theantennaguy/vco-max2870-evalboard/max2871-evalboard/datasheets/Stackup.png

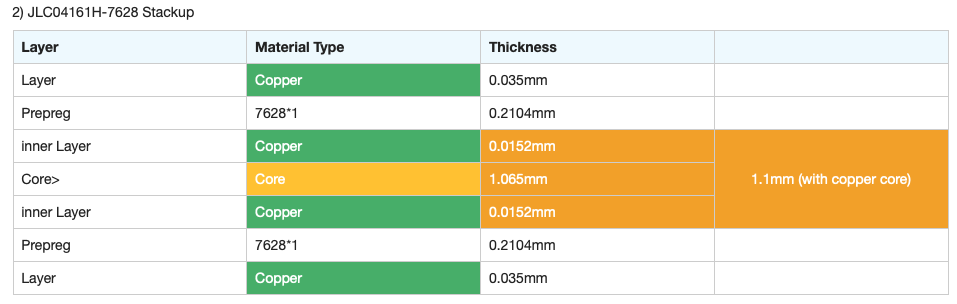
max2871-evalboard/datasheets/Stackup.png
