theantennaguy/vco-max2870-evalboard/max2871-evalboard/parts/CONSMA002-L_SMA_COAX_CONN/CONSMA002-L.step

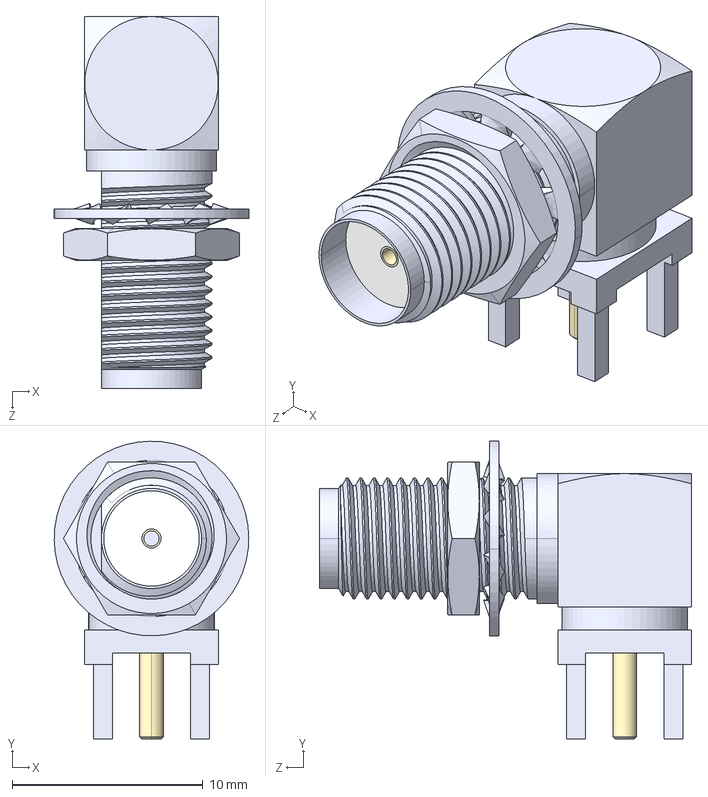
[picture p2: CAD file, 2022-12-02]
max2871-evalboard/parts/CONSMA002-L_SMA_COAX_CONN/CONSMA002-L.step
10.2 x 15.6 x 19.5 mm
CONSMA002-L-body
Nut
Washer
