theantennaguy/vco-max2870-evalboard/max2871-evalboard/parts/IRF7301.STEP

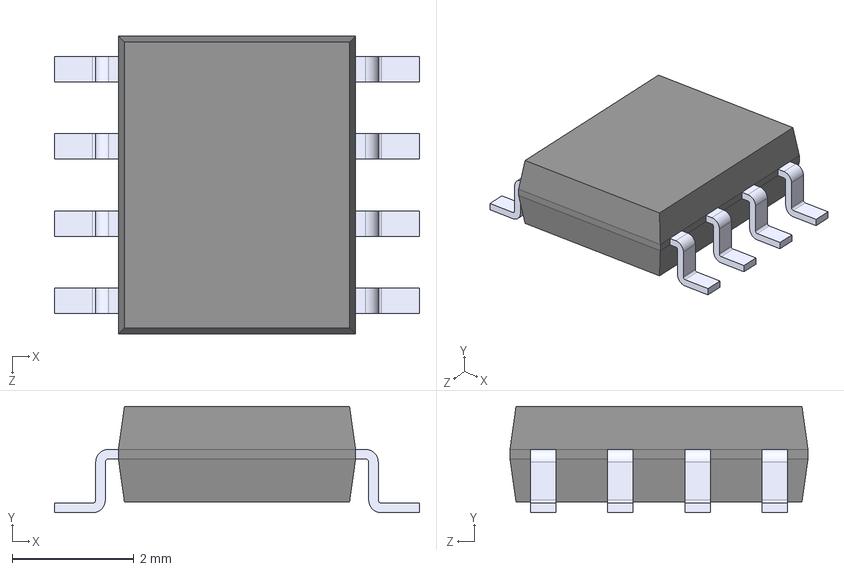
[picture p3: CAD file, 2022-12-21]
max2871-evalboard/parts/IRF7301.STEP
6.00 x 1.75 x 4.90 mm
