theantennaguy/vco-max2870-evalboard/max2871-evalboard/parts/LMH2110TM_NOPB/LMH2110TM_NOPB.step

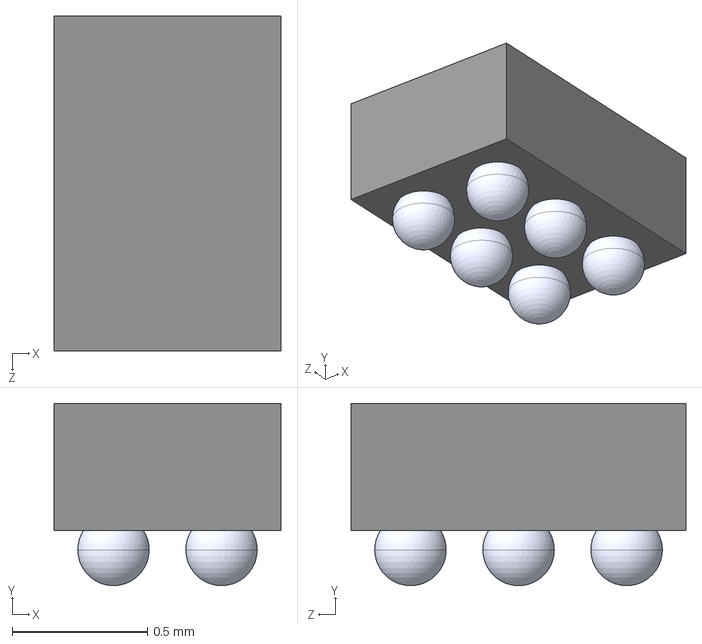
[picture p4: CAD file, 2023-01-11]
max2871-evalboard/parts/LMH2110TM_NOPB/LMH2110TM_NOPB.step
0.84 x 0.675 x 1.24 mm
