theantennaguy/vco-max2870-evalboard/max2871-evalboard/parts/MAX2871ETJ/MAX2871ETJ_.step

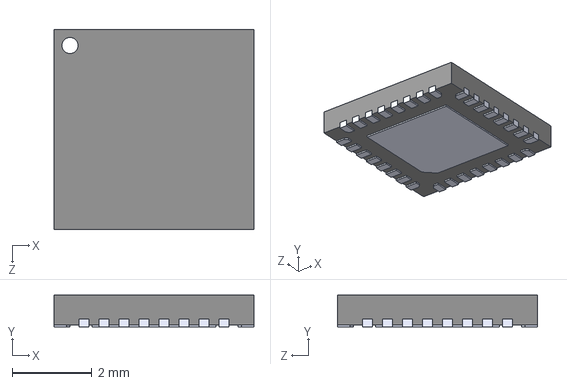
[picture p5: CAD file, 2022-12-02]
max2871-evalboard/parts/MAX2871ETJ/MAX2871ETJ_.step
5.00 x 0.8 x 5.00 mm
