theantennaguy/vco-max2870-evalboard/max2871-evalboard/parts/MAX8559ETAAAT/MAX8559ETAAAT.step

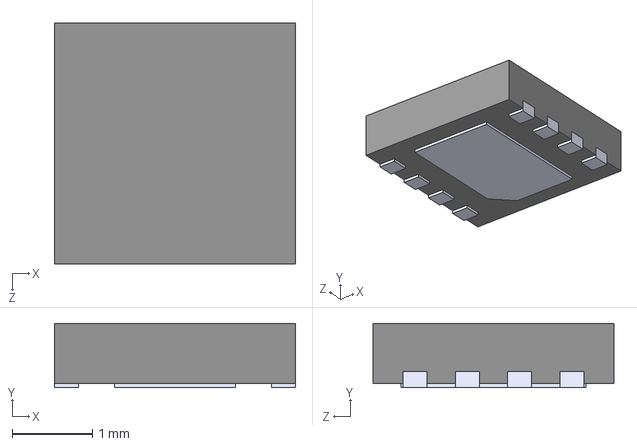
[picture p6: CAD file, 2022-12-02]
max2871-evalboard/parts/MAX8559ETAAAT/MAX8559ETAAAT.step
3.00 x 0.8 x 3.00 mm
