theantennaguy/vco-max2870-evalboard/max2871-evalboard/parts/TL3365AF180QG/TL3365AF180QG.step

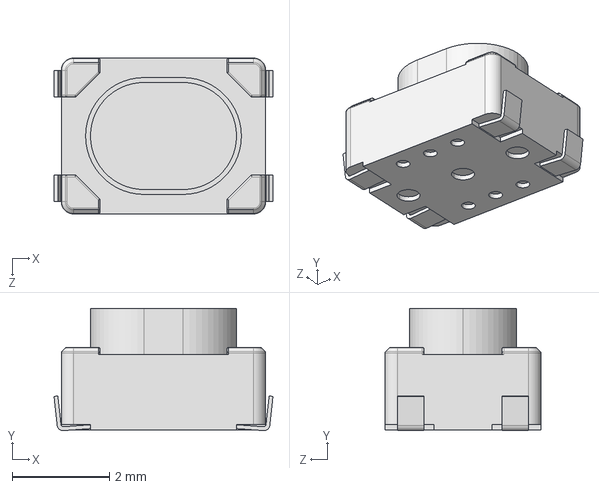
[picture p7: CAD file, 2022-12-02]
max2871-evalboard/parts/TL3365AF180QG/TL3365AF180QG.step
4.50 x 2.51 x 3.20 mm
