theantennaguy/vco-max2870-evalboard/max2871-evalboard/parts/USB-B1HSB6/USB-B1HSB6.step

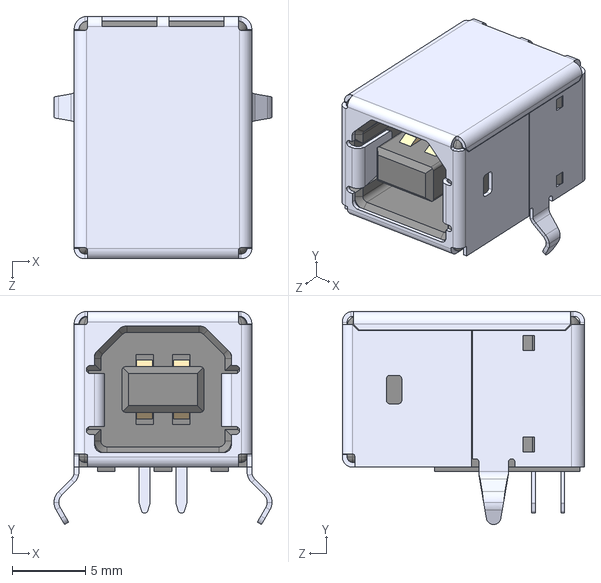
[picture p8: CAD file, 2022-12-02]
max2871-evalboard/parts/USB-B1HSB6/USB-B1HSB6.step
14.8 x 14.5 x 16.5 mm
