theantennaguy/vco-max2870-evalboard/max2871-evalboard/parts/USB4105-GF-A/USB4105-GF-A.step

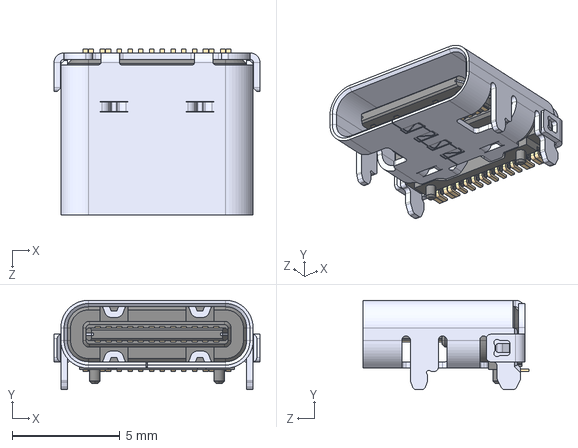
[picture p9: CAD file, 2023-01-11]
max2871-evalboard/parts/USB4105-GF-A/USB4105-GF-A.step
9.58 x 4.16 x 7.71 mm
