theantennaguy/vco-max2870-evalboard/max2871-evalboard/parts/54819-0519/54819-0519.step

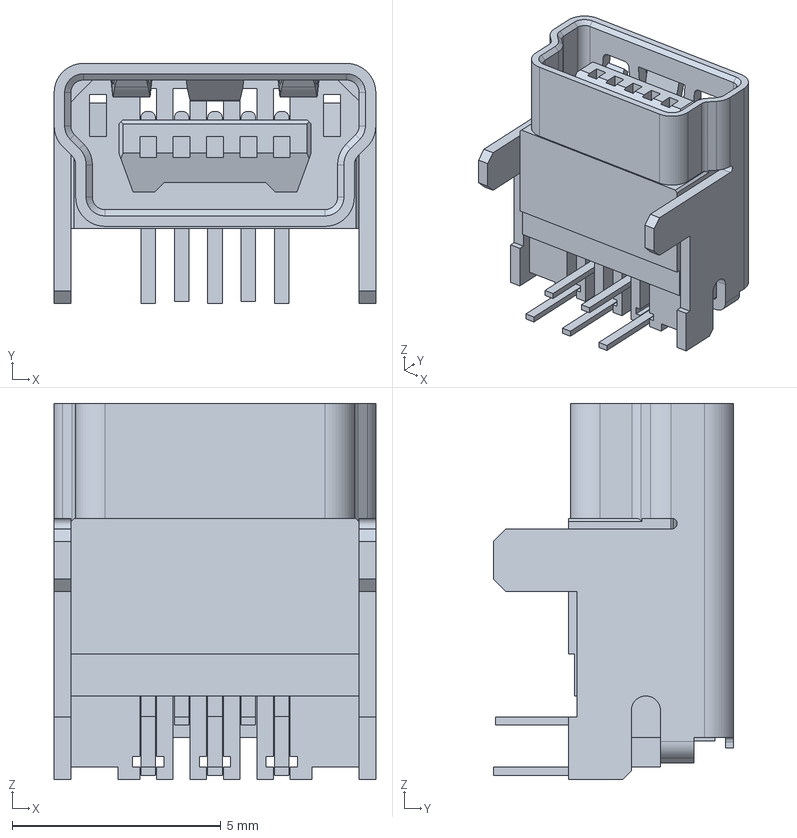
[picture p10: CAD file, 2022-12-05]
max2871-evalboard/parts/54819-0519/54819-0519.step
7.70 x 5.75 x 9.00 mm
