theantennaguy/vco-max2870-evalboard/max2871-evalboard/parts/1455C801.stp

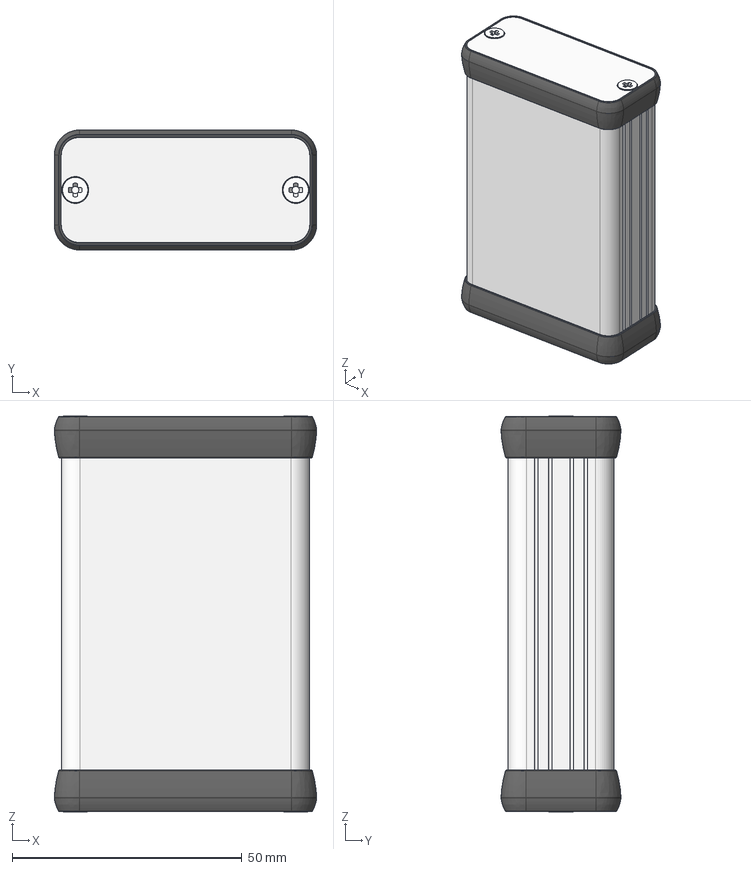
[picture p11: CAD file, 2022-12-02]
max2871-evalboard/parts/1455C801.stp
57.1 x 26.1 x 86.2 mm
C Extrusion
C Bezel Open x 2
C End Plate x 2
1455 screw x 4
