theantennaguy/vco-max2870-evalboard/max2871-evalboard/max2871-evalboard.kicad_pcb

## KiCad design max2871-evalboard/max2871-evalboard.kicad_pcb (2023-01-17)

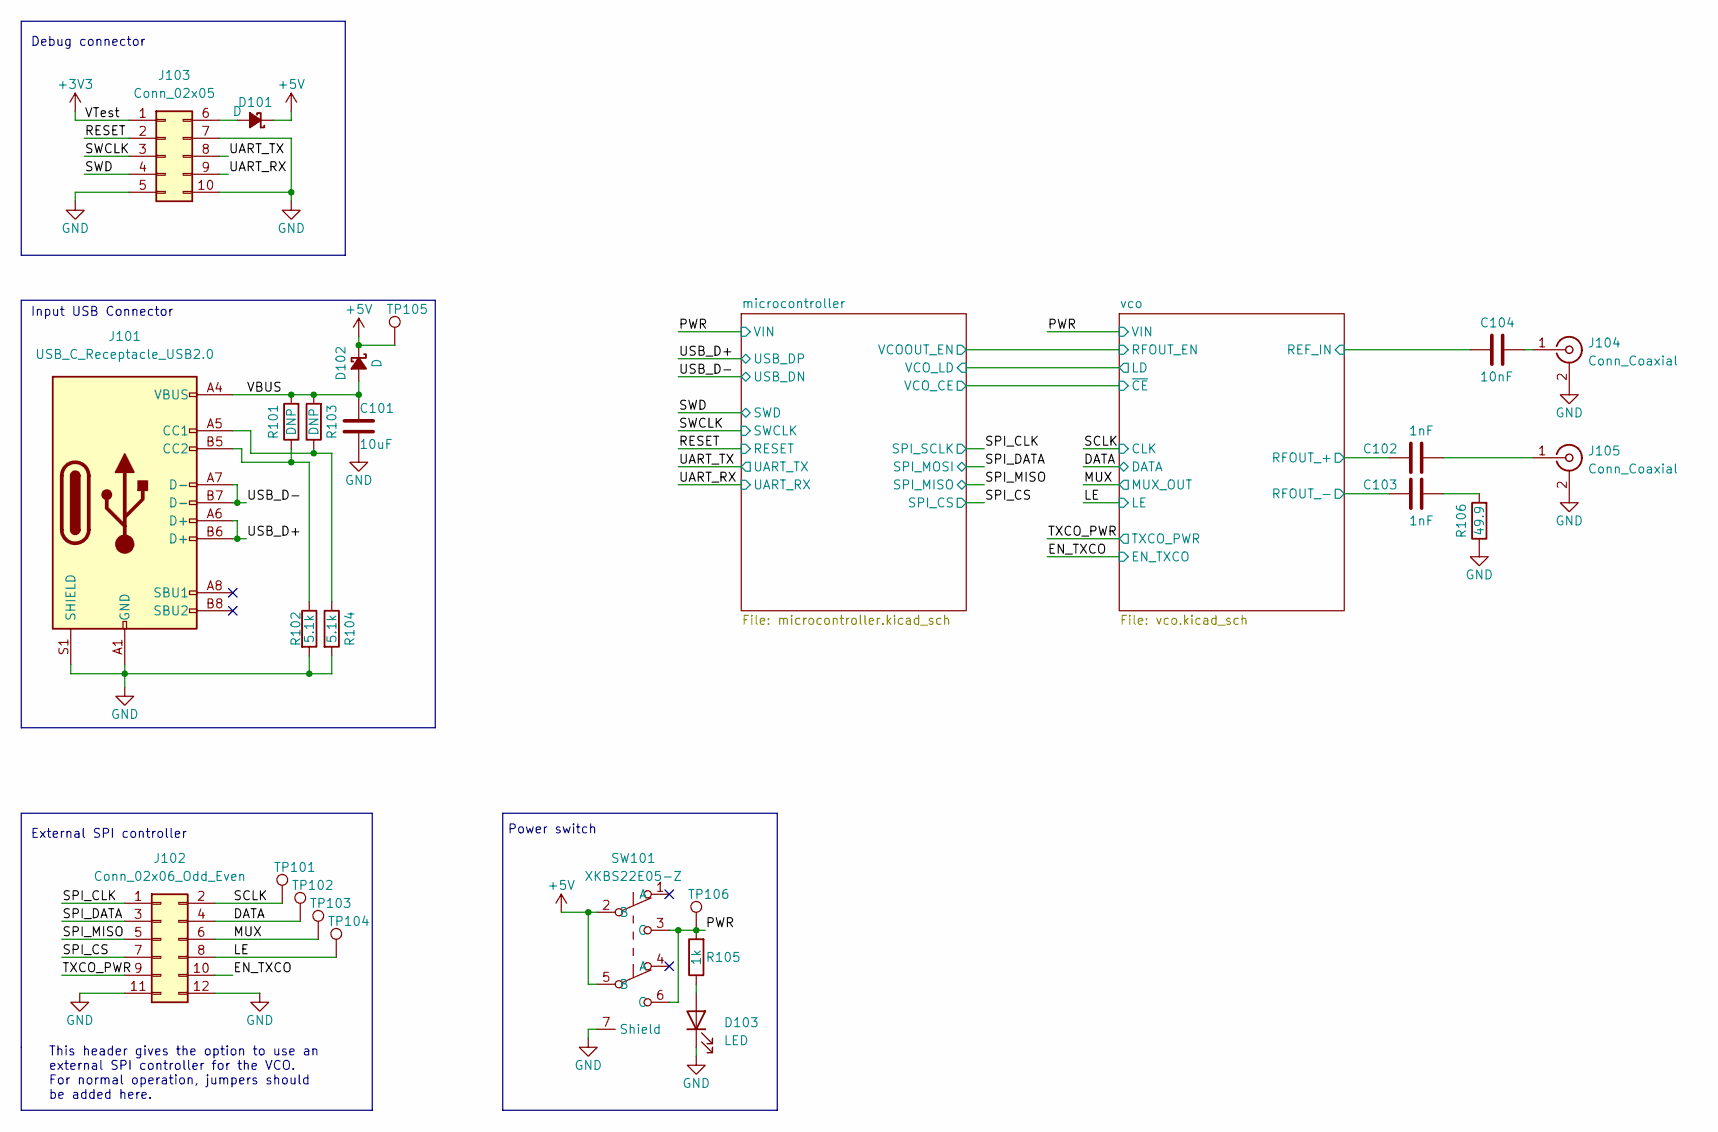
[picture p12: schematic max2871-evalboard.kicad_sch, MAX2871 Eval Board]

Parts:
C101: 10uF; C_0603_1608Metric; Part Number CL10A106MO8NQNC; LCSC C92487
C102, C103: 1nF; C_0402_1005Metric; Part Number GCM155R71H102KA37D; LCSC C126532
C104: 10nF; C_0402_1005Metric; Part Number TMK105B7103KVHF; LCSC C650944
D101, D102: D; D_SMA; Part Number SS12; LCSC C2898535
D103: LED; LED_D3.0mm_Horizontal_O3.81mm_Z2.0mm
J101: USB_C_Receptacle_USB2.0; GCT_USB4105-GF-A; Part Number USB4105-GF-A
J102: Conn_02x06_Odd_Even; PinHeader_2x06_P2.54mm_Horizontal; Part Number PZ254R-12-12P; LCSC C492434
J103: Conn_02x05; PinHeader_2x05_P1.27mm_Vertical
J104, J105: Conn_Coaxial; LINX_CONSMA002-L; Part Number DOSIN-806-0186; LCSC C709668
R101, R103: DNP; R_0402_1005Metric
R102, R104: 5.1k; R_0402_1005Metric; Part Number PTFR0402B5K10N9; LCSC C351692
R105: 1k; R_0402_1005Metric; Part Number RT0402CRE071KL; LCSC C705665
R106: 49.9; R_0402_1005Metric; Part Number PTFR0402B49R9N9; LCSC C2692754
SW101: XKBS22E05-Z; Part Number XKBS22E05-Z; LCSC C692489
TP101, TP102, TP103, TP104: TestPoint_Pad_D1.0mm
TP105, TP106: TestPoint_Pad_D1.5mm

Connections:
+3V3: J103.1; also elsewhere on the board
+5V: D101.1 (K), D102.1 (K), SW101.2 (B), SW101.5 (B), TP105.1
/DATA: J102.4, TP102.1; also elsewhere on the board
/EN_TXCO: J102.10; also elsewhere on the board
/LE: J102.8, TP104.1; also elsewhere on the board
/MUX: J102.6, TP103.1; also elsewhere on the board
/PWR: R105.2, SW101.3 (C), SW101.6 (C), TP106.1; also elsewhere on the board
/RESET: J103.2; also elsewhere on the board
/SCLK: J102.2, TP101.1; also elsewhere on the board
/SPI_CLK: J102.1; also elsewhere on the board
/SPI_CS: J102.7; also elsewhere on the board
/SPI_DATA: J102.3; also elsewhere on the board
/SPI_MISO: J102.5; also elsewhere on the board
/SWCLK: J103.3; also elsewhere on the board
/SWD: J103.4; also elsewhere on the board
/TXCO_PWR: J102.9; also elsewhere on the board
/UART_RX: J103.9; also elsewhere on the board
/UART_TX: J103.8; also elsewhere on the board
/USB_D+: J101.A6 (D+), J101.B6 (D+); also elsewhere on the board
/USB_D-: J101.A7 (D-), J101.B7 (D-); also elsewhere on the board
/VBUS: C101.1, D102.2 (A), J101.A4 (VBUS), J101.A9 (VBUS), J101.B4 (VBUS), J101.B9 (VBUS), R101.2, R103.2
/vco/REF_CLK: C104.2; also elsewhere on the board
/vco/RFOUT_N: C103.1; also elsewhere on the board
/vco/RFOUT_P: C102.1; also elsewhere on the board
GND: C101.2, D103.1 (K), J101.A1 (GND), J101.A12 (GND), J101.B1 (GND), J101.B12 (GND), J101.S1 (SHIELD), J102.11, J102.12, J103.5, J103.7, J103.10, J104.2 (Ext), J105.2 (Ext), R102.2, R104.2, R106.1, SW101.7 (Shield); also elsewhere on the board
unnamed: C102.2, J105.1 (In)
unnamed: C103.2, R106.2
unnamed: C104.1, J104.1 (In)
unnamed: D101.2 (A), J103.6
unnamed: D103.2 (A), R105.1
unnamed: J101.A5 (CC1), R103.1, R104.1
unnamed: J101.B5 (CC2), R101.1, R102.1

Notes on the sheet:
Input USB Connector
Power switch
Debug connector
This header gives the option to use an external SPI controller for the VCO. For normal operation, jumpers should be added here.
External SPI controller

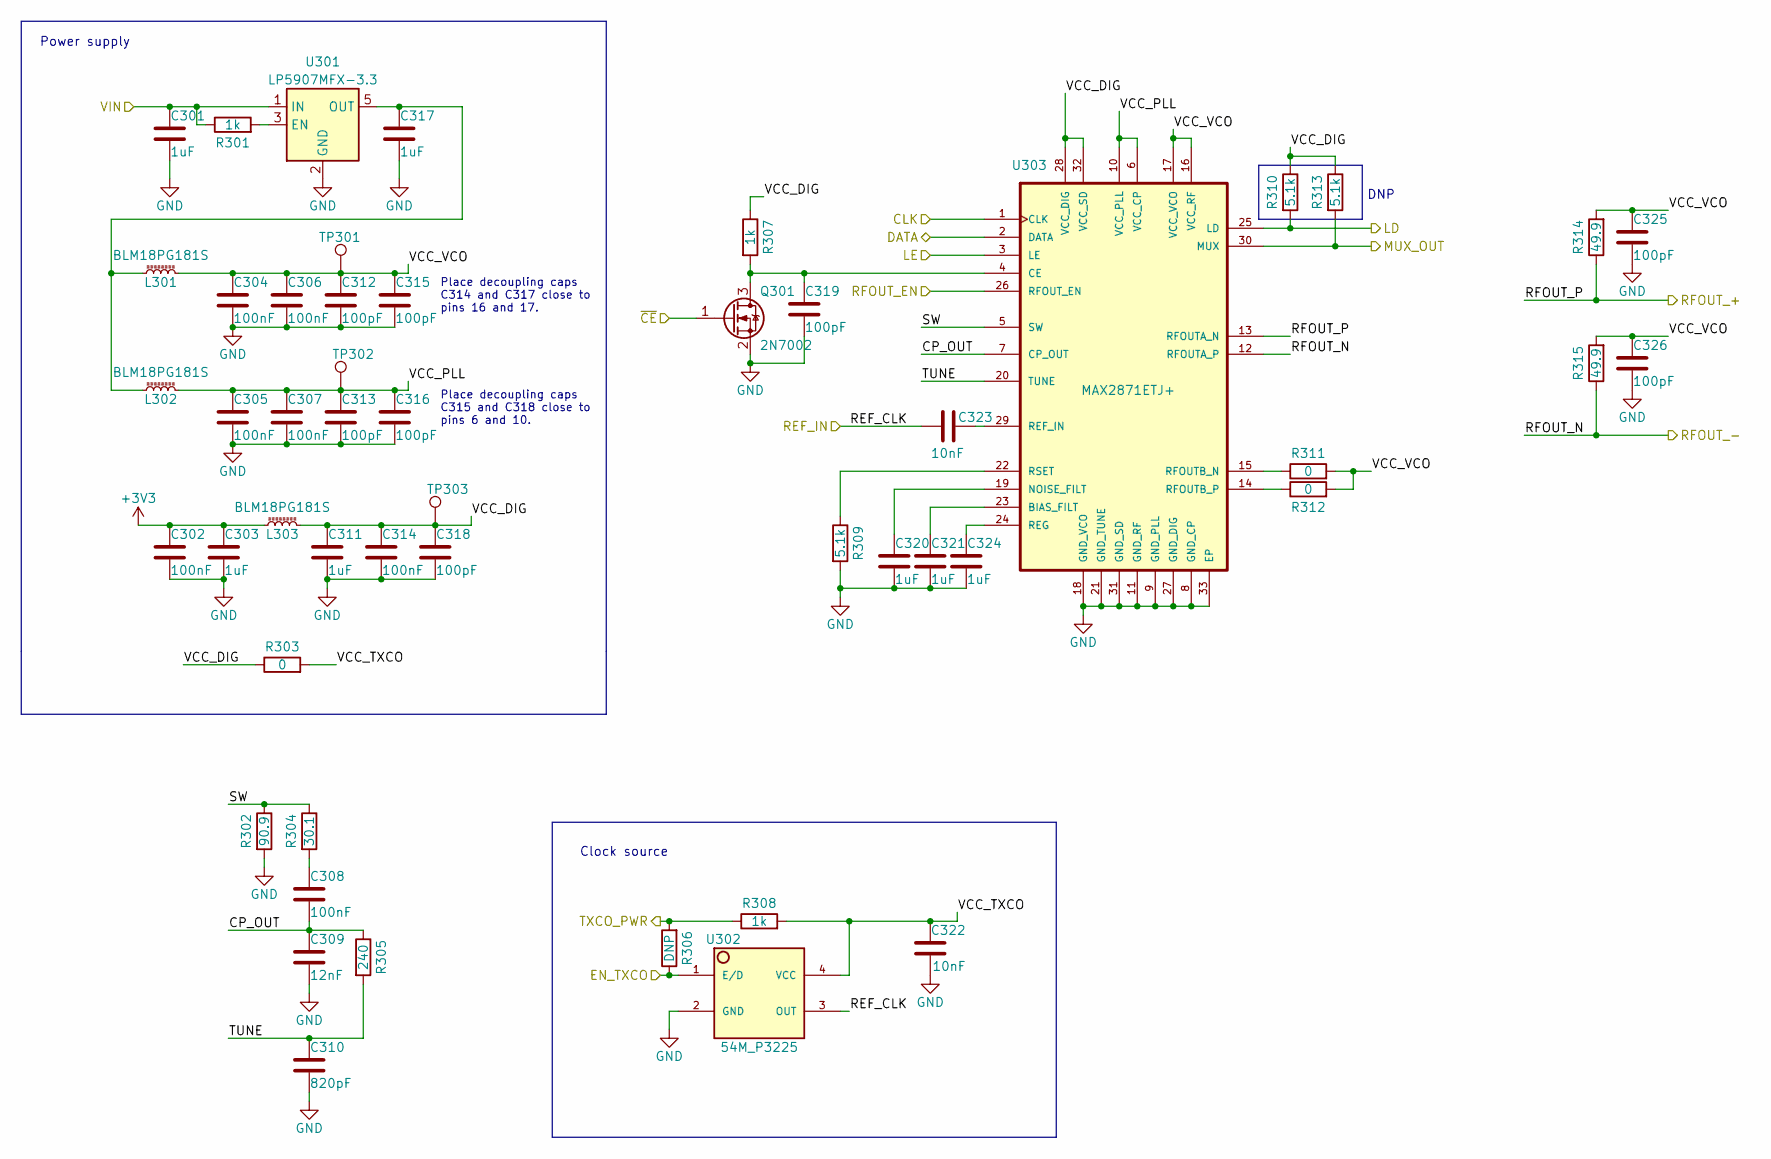
[picture p13: schematic vco.kicad_sch]

Parts:
C301, C303, C311, C317, C320, C321, C324: 1uF; C_0402_1005Metric; Part Number GCM155C71A105KE38D; LCSC C126521
C302, C304, C305, C306, C307, C308, C314: 100nF; C_0402_1005Metric; Part Number CL05F104ZO5NNNC; LCSC C84701
C309: 12nF; C_0402_1005Metric; Part Number CC0402KRX7R8BB123; LCSC C113786
C310: 820pF; C_0402_1005Metric; Part Number CC0402KRX7R9BB821; LCSC C107031
C312, C313, C315, C316, C318, C319, C325, C326: 100pF; C_0402_1005Metric; Part Number CC0402KRX7R7BB101; LCSC C541374
C322, C323: 10nF; C_0402_1005Metric; Part Number TMK105B7103KVHF; LCSC C650944
L301, L302, L303: BLM18PG181S; L_0603_1608Metric; Part Number BLM18PG181SH1D; LCSC C710383
Q301: 2N7002; SOT-23; Part Number 2N7002; LCSC C389059
R301, R307, R308: 1k; R_0402_1005Metric; Part Number RT0402CRE071KL; LCSC C705665
R302: 90.9; R_0402_1005Metric; Part Number RT0402BRD0790R9L; LCSC C852950
R303, R311, R312: 0; R_0402_1005Metric; Part Number PA0402-R-070RL; LCSC C4044221
R304: 30.1; R_0402_1005Metric; Part Number PTFR0402B49R9N9; LCSC C2692754
R305: 240; R_0402_1005Metric; Part Number PTFR0402B49R9N9; LCSC C2692754
R306: DNP; R_0603_1608Metric
R309, R310, R313: 5.1k; R_0402_1005Metric; Part Number PTFR0402B5K10N9; LCSC C351692
R314, R315: 49.9; R_0402_1005Metric; Part Number PTFR0402B49R9N9; LCSC C2692754
TP301, TP302, TP303: TestPoint_Pad_D1.5mm
U301: LP5907MFX-3.3; SOT-23-5; Part Number LP5907QMFX-3.3Q1; LCSC C130005
U302: 54M_P3225; Crystal_SMD_3225-4Pin_3.2x2.5mm; Part Number O3254000153350; LCSC C437135
U303: MAX2871ETJ+; QFN50P500X500X80-33N; Partnumber MAX2871ETJ+

Connections:
+3V3: C302.1, C303.1, L303.1; also elsewhere on the board
/DATA: U303.2 (DATA); also elsewhere on the board
/EN_TXCO: R306.1, U302.1 (E/D); also elsewhere on the board
/LE: U303.3 (LE); also elsewhere on the board
/MUX: R313.2, U303.30 (MUX); also elsewhere on the board
/PWR: C301.1, R301.1, U301.1 (IN); also elsewhere on the board
/SCLK: U303.1 (CLK); also elsewhere on the board
/TXCO_PWR: R306.2, R308.1; also elsewhere on the board
/microcontroller/VCOOUT_EN: U303.26 (RFOUT_EN); also elsewhere on the board
/microcontroller/VCO_CE: Q301.1 (G); also elsewhere on the board
/microcontroller/VCO_LD: R310.2, U303.25 (LD); also elsewhere on the board
/vco/CP_OUT: C308.2, C309.1, R305.1, U303.7 (CP_OUT)
/vco/REF_CLK: C323.2, U302.3 (OUT); also elsewhere on the board
/vco/RFOUT_N: R315.1, U303.12 (RFOUTA_P); also elsewhere on the board
/vco/RFOUT_P: R314.1, U303.13 (RFOUTA_N); also elsewhere on the board
/vco/SW: R302.1, R304.1, U303.5 (SW)
/vco/TUNE: C310.1, R305.2, U303.20 (TUNE)
/vco/VCC_DIG: C311.1, C314.1, C318.1, L303.2, R303.1, R307.1, R310.1, R313.1, TP303.1, U303.28 (VCC_DIG), U303.32 (VCC_SD)
/vco/VCC_PLL: C305.1, C307.1, C313.1, C316.1, L302.2, TP302.1, U303.6 (VCC_CP), U303.10 (VCC_PLL)
/vco/VCC_TXCO: C322.2, R303.2, R308.2, U302.4 (VCC)
/vco/VCC_VCO: C304.1, C306.1, C312.1, C315.1, C325.1, C326.1, L301.2, R311.2, R312.2, R314.2, R315.2, TP301.1, U303.16 (VCC_RF), U303.17 (VCC_VCO)
GND: C301.2, C302.2, C303.2, C304.2, C305.2, C306.2, C307.2, C309.2, C310.2, C311.2, C312.2, C313.2, C314.2, C315.2, C316.2, C317.2, C318.2, C319.2, C320.2, C321.2, C322.1, C324.2, C325.2, C326.2, Q301.2 (S), R302.2, R309.2, U301.2 (GND), U302.2 (GND), U303.8 (GND_CP), U303.9 (GND_PLL), U303.11 (GND_RF), U303.18 (GND_VCO), U303.21 (GND_TUNE), U303.27 (GND_DIG), U303.31 (GND_SD), U303.33 (EP); also elsewhere on the board
unnamed: C308.1, R304.2
unnamed: C317.1, L301.1, L302.1, U301.5 (OUT)
unnamed: C319.1, Q301.3 (D), R307.2, U303.4 (CE)
unnamed: C320.1, U303.19 (NOISE_FILT)
unnamed: C321.1, U303.23 (BIAS_FILT)
unnamed: C323.1, U303.29 (REF_IN)
unnamed: C324.1, U303.24 (REG)
unnamed: R301.2, U301.3 (EN)
unnamed: R309.1, U303.22 (RSET)
unnamed: R311.1, U303.15 (RFOUTB_N)
unnamed: R312.1, U303.14 (RFOUTB_P)

Notes on the sheet:
Clock source
Place decoupling caps C314 and C317 close to pins 16 and 17.
Power supply
DNP
Place decoupling caps C315 and C318 close to pins 6 and 10.

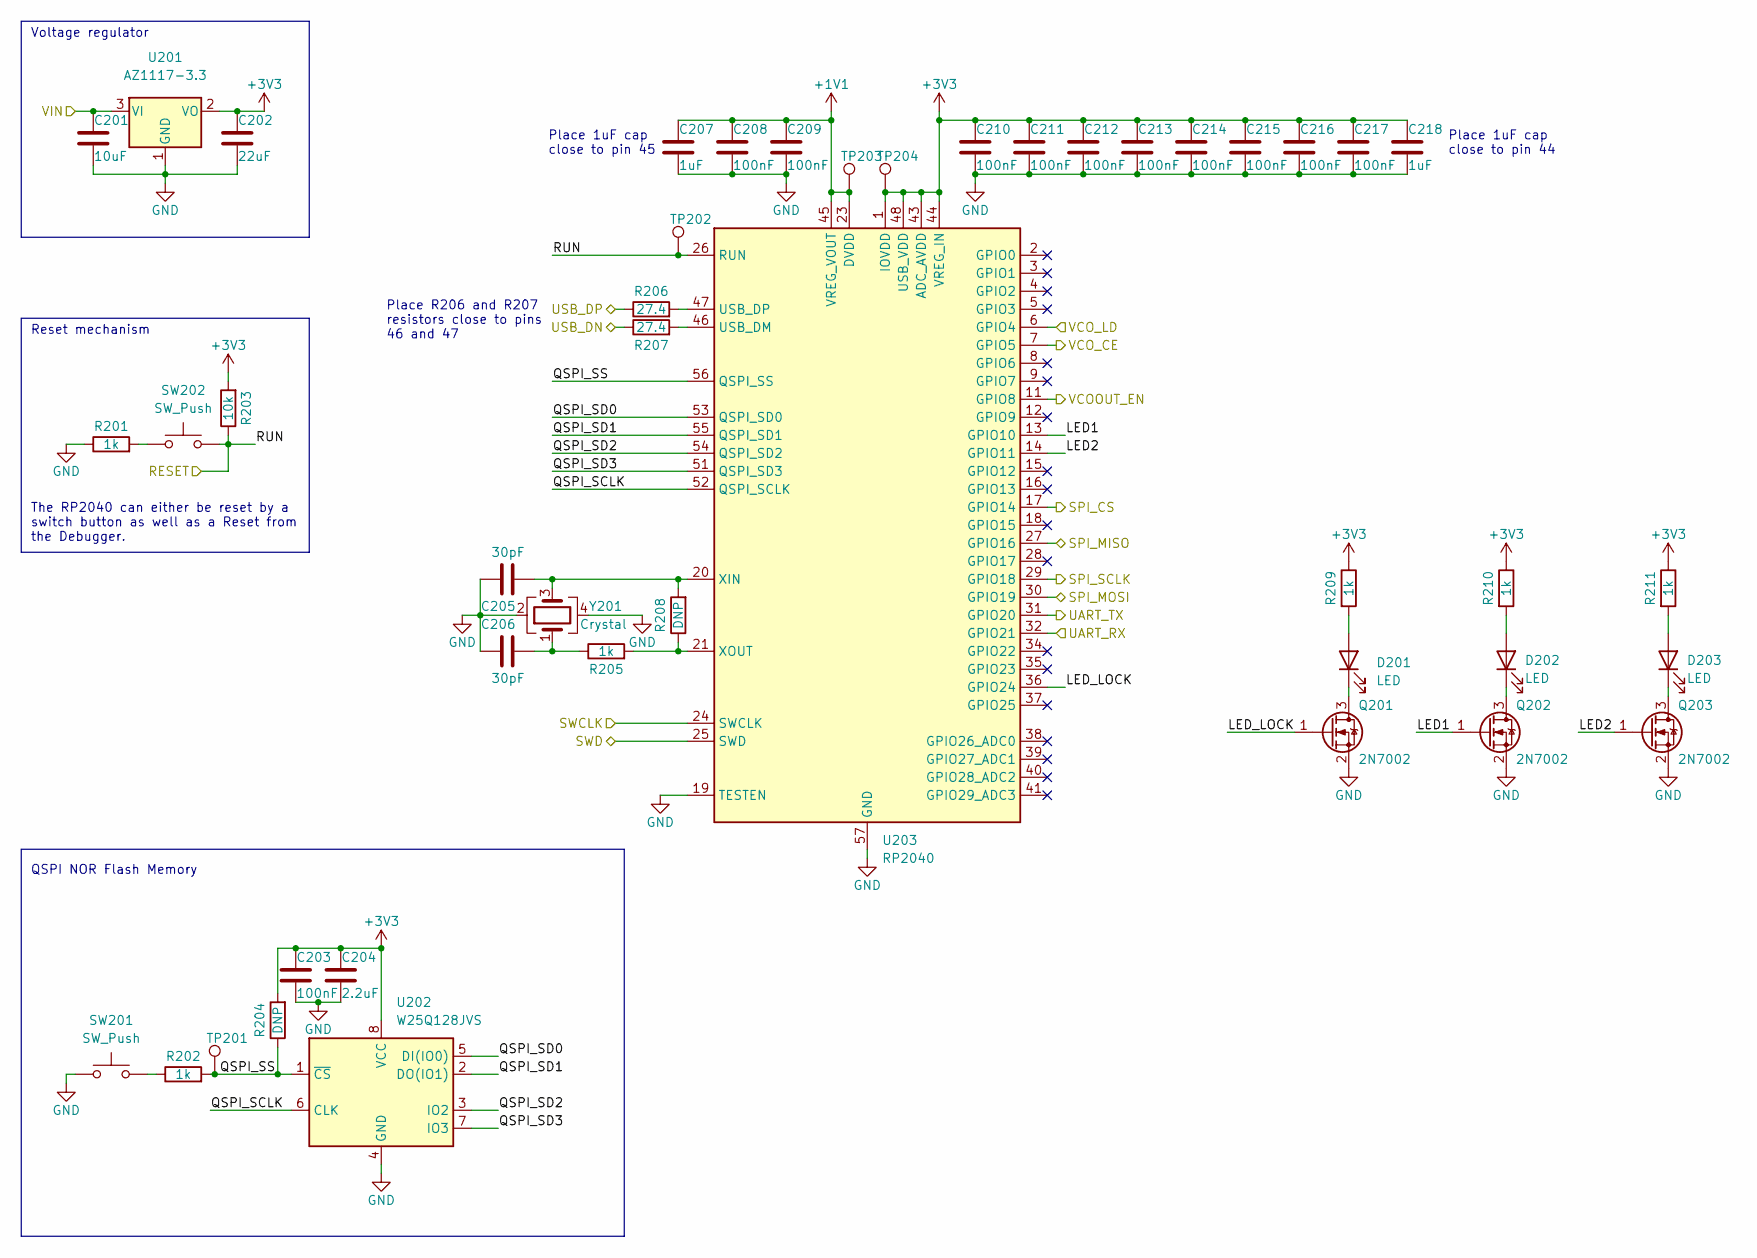
[picture p14: schematic microcontroller.kicad_sch]

Parts:
C201: 10uF; C_0603_1608Metric; Part Number CL10A106MO8NQNC; LCSC C92487
C202: 22uF; C_0805_2012Metric; Part Number CL21A226MAYNNNE; LCSC C602037
C203, C208, C209, C210, C211, C212, C213, C214, C215, C216, C217: 100nF; C_0402_1005Metric; Part Number CL05F104ZO5NNNC; LCSC C84701
C204: 2.2uF; C_0402_1005Metric; Part Number CL05F104ZO5NNNC; LCSC C84701
C205, C206: 30pF; C_0402_1005Metric; Part Number GCM1555C1H300JA16D; LCSC C161152
C207, C218: 1uF; C_0402_1005Metric; Part Number GCM155C71A105KE38D; LCSC C126521
D201: LED; LED_D3.0mm_Horizontal_O3.81mm_Z2.0mm
D202, D203: LED; LED_0603_1608Metric; Part Number 19-217/GHC-YR1S2/3T; LCSC C72043
Q201, Q202, Q203: 2N7002; SOT-23; Part Number 2N7002; LCSC C389059
R201, R202, R205, R209, R210, R211: 1k; R_0402_1005Metric; Part Number RT0402CRE071KL; LCSC C705665
R203: 10k; R_0402_1005Metric; Part Number RT0402BRC0710KL; LCSC C852428
R204, R208: DNP; R_0402_1005Metric
R206, R207: 27.4; R_0402_1005Metric; Part Number 0402WGF274JTCE; LCSC C31439
SW201, SW202: SW_Push; SW_TL3365AF180QG; Part Number TSA017A2540A03; LCSC C2888435
TP201, TP202, TP203, TP204: TestPoint_Pad_D1.5mm
U201: AZ1117-3.3; SOT-223-3_TabPin2; Part Number AZ1117H-3.3TRE1; LCSC C92517
U202: W25Q128JVS; SOIC-8_5.23x5.23mm_P1.27mm; Part Number W25Q128JVSIQ; LCSC C113767
U203: RP2040; QFN-56-1EP_7x7mm_P0.4mm_EP3.2x3.2mm; Part Number RP2040; LCSC C2040
Y201: Crystal; Crystal_SMD_3225-4Pin_3.2x2.5mm; Part Number TAXM12M4RLBDDT2T; LCSC C133334

Connections:
+1V1: C207.1, C208.1, C209.1, TP203.1, U203.23 (DVDD), U203.45 (VREG_VOUT), U203.50 (DVDD)
+3V3: C202.1, C203.1, C204.1, C210.1, C211.1, C212.1, C213.1, C214.1, C215.1, C216.1, C217.1, C218.1, R203.2, R204.2, R209.1, R210.1, R211.1, TP204.1, U201.2 (VO), U202.8 (VCC), U203.1 (IOVDD), U203.10 (IOVDD), U203.22 (IOVDD), U203.33 (IOVDD), U203.42 (IOVDD), U203.43 (ADC_AVDD), U203.44 (VREG_IN), U203.48 (USB_VDD), U203.49 (IOVDD); also elsewhere on the board
/PWR: C201.1, U201.3 (VI); also elsewhere on the board
/RESET: R203.1, SW202.2, TP202.1, U203.26 (RUN); also elsewhere on the board
/SPI_CLK: U203.29 (GPIO18); also elsewhere on the board
/SPI_CS: U203.17 (GPIO14); also elsewhere on the board
/SPI_DATA: U203.30 (GPIO19); also elsewhere on the board
/SPI_MISO: U203.27 (GPIO16); also elsewhere on the board
/SWCLK: U203.24 (SWCLK); also elsewhere on the board
/SWD: U203.25 (SWD); also elsewhere on the board
/UART_RX: U203.32 (GPIO21); also elsewhere on the board
/UART_TX: U203.31 (GPIO20); also elsewhere on the board
/USB_D+: R206.1; also elsewhere on the board
/USB_D-: R207.1; also elsewhere on the board
/microcontroller/LED1: Q202.1 (G), U203.13 (GPIO10)
/microcontroller/LED2: Q203.1 (G), U203.14 (GPIO11)
/microcontroller/LED_LOCK: Q201.1 (G), U203.36 (GPIO24)
/microcontroller/QSPI_SCLK: U202.6 (CLK), U203.52 (QSPI_SCLK)
/microcontroller/QSPI_SD0: U202.5 (DI(IO0)), U203.53 (QSPI_SD0)
/microcontroller/QSPI_SD1: U202.2 (DO(IO1)), U203.55 (QSPI_SD1)
/microcontroller/QSPI_SD2: U202.3 (IO2), U203.54 (QSPI_SD2)
/microcontroller/QSPI_SD3: U202.7 (IO3), U203.51 (QSPI_SD3)
/microcontroller/QSPI_SS: R202.2, R204.1, TP201.1, U202.1 (~CS), U203.56 (QSPI_SS)
/microcontroller/VCOOUT_EN: U203.11 (GPIO8); also elsewhere on the board
/microcontroller/VCO_CE: U203.7 (GPIO5); also elsewhere on the board
/microcontroller/VCO_LD: U203.6 (GPIO4); also elsewhere on the board
GND: C201.2, C202.2, C203.2, C204.2, C205.1, C206.1, C207.2, C208.2, C209.2, C210.2, C211.2, C212.2, C213.2, C214.2, C215.2, C216.2, C217.2, C218.2, Q201.2 (S), Q202.2 (S), Q203.2 (S), R201.1, SW201.1, U201.1 (GND), U202.4 (GND), U203.19 (TESTEN), U203.57 (GND), Y201.2, Y201.4; also elsewhere on the board
unnamed: C205.2, R208.2, U203.20 (XIN), Y201.3
unnamed: C206.2, R205.1, Y201.1
unnamed: D201.1 (K), Q201.3 (D)
unnamed: D201.2 (A), R209.2
unnamed: D202.1 (K), Q202.3 (D)
unnamed: D202.2 (A), R210.2
unnamed: D203.1 (K), Q203.3 (D)
unnamed: D203.2 (A), R211.2
unnamed 67: R201.2, SW202.1; also elsewhere on the board
unnamed 68: R202.1, SW201.2; also elsewhere on the board
unnamed: R205.2, R208.1, U203.21 (XOUT)
unnamed: R206.2, U203.47 (USB_DP)
unnamed: R207.2, U203.46 (USB_DM)

Notes on the sheet:
Place R206 and R207 resistors close to pins 46 and 47
The RP2040 can either be reset by a switch button as well as a Reset from the Debugger.
Place 1uF cap close to pin 45
Voltage regulator
Place 1uF cap close to pin 44
Reset mechanism
QSPI NOR Flash Memory

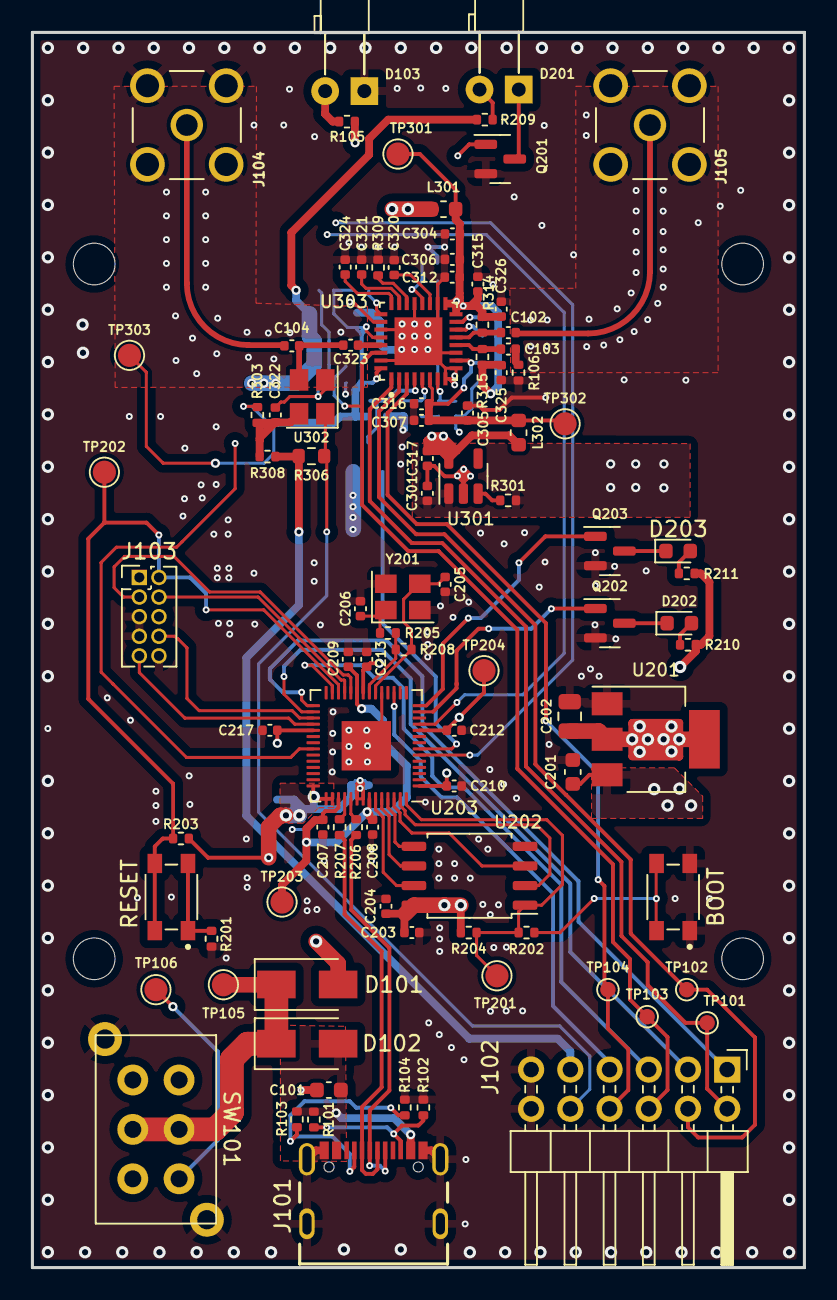
[picture p15: board max2871-evalboard.kicad_pcb from above]

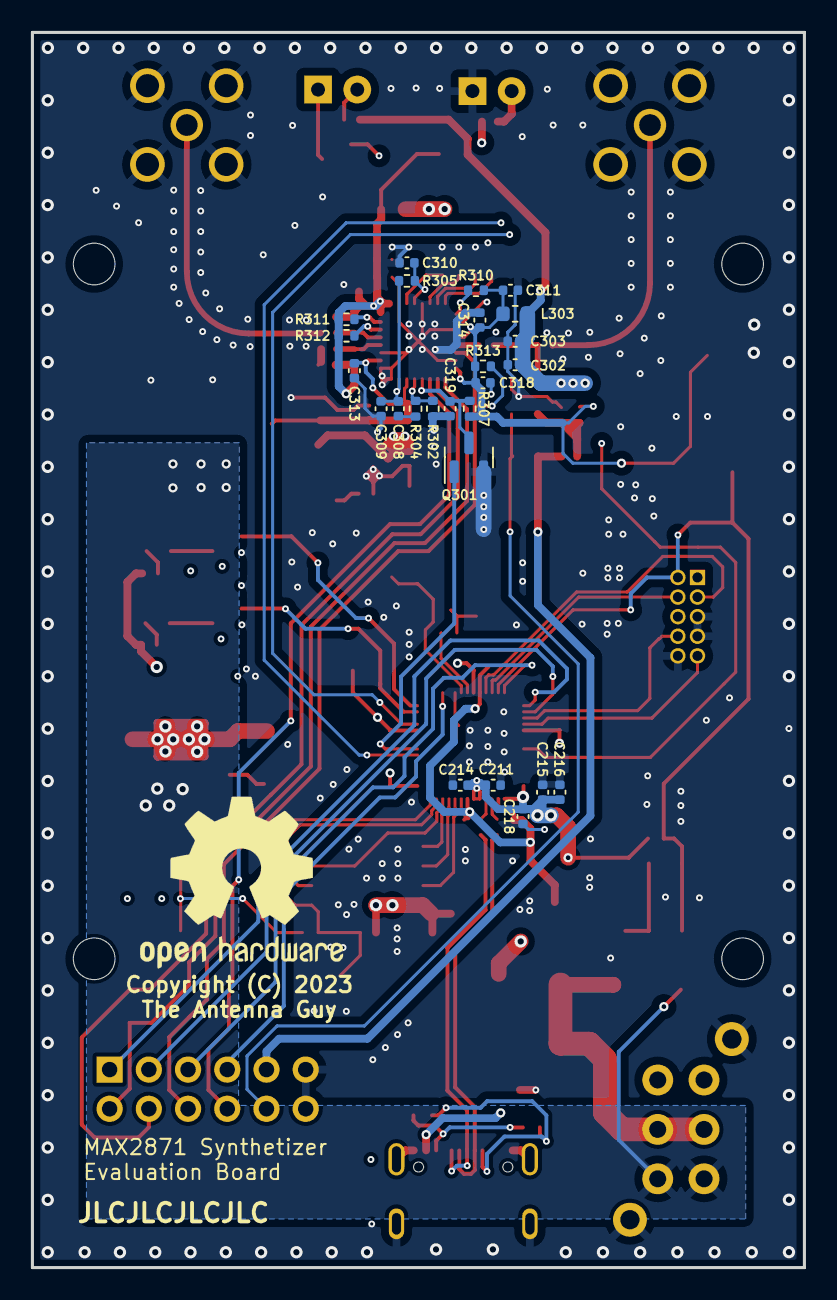
[picture p16: board max2871-evalboard.kicad_pcb from below]

Board: 4 copper layers, 50.0 x 80.0 mm, 121 parts (25 on the bottom side), 76 nets.

Other parts of the board:
BOOT: SW_Push; SW_TL3365AF180QG
RESET: SW_Push; SW_TL3365AF180QG

Their connections:
/RESET: RESET.2; also elsewhere on the board
GND: BOOT.1; also elsewhere on the board
unnamed 67: RESET.1; also elsewhere on the board
unnamed 68: BOOT.2; also elsewhere on the board
