theantennaguy/vco-max2870-evalboard/(commit log)

2022-11-28 Create_project and setup license
    [max2870-evalboard.kicad_pcb, max2870-evalboard.kicad_sch]
2022-11-28 Update project name
    [max2871-evalboard.kicad_pcb, max2871-evalboard.kicad_sch]
2022-12-02 Update Schematic
    [1455C801.stp, CONSMA002-L.step, MAX2871ETJ_.step, MAX8559ETAAAT.step, TL3365AF180QG.step, USB-B1HSB6.step, microcontroller.kicad_sch, vco.kicad_sch]
2022-12-05 Finish schematic - create PCB
    [54819-0519.step, max2871-evalboard.csv, max2871-evalboard.kicad_pcb, max2871-evalboard.kicad_sch, microcontroller.kicad_sch, vco.kicad_sch]
2022-12-18 Finished schematics - started PCB design
    [max2871-evalboard.kicad_pcb]
2022-12-21 PCB placement complete
    [IRF7301.STEP, max2871-evalboard.kicad_pcb, max2871-evalboard.kicad_sch, microcontroller.kicad_sch, vco.kicad_sch]
2022-12-26 Finish PCB design
    [max2871-evalboard.kicad_pcb]
2023-01-11 Finish layout design
    [LMH2110TM_NOPB.step, USB4105-GF-A.step, max2871-evalboard.csv, max2871-evalboard.kicad_pcb, max2871-evalboard.kicad_sch, microcontroller.kicad_sch, vco.kicad_sch]
2023-01-17 Finish PCB - generate fabrication files
    [max2871-evalboard-B_Cu.gbl, max2871-evalboard-B_Mask.gbs, max2871-evalboard-B_Paste.gbp, max2871-evalboard-B_Silkscreen.gbo, max2871-evalboard-Edge_Cuts.gm1, max2871-evalboard-F_Cu.gtl, max2871-evalboard-F_Mask.gts, max2871-evalboard-F_Paste.gtp]
