theantennaguy/vco-max2870-evalboard/(notices)

Notices in the files:
max2871-evalboard/max2871-evalboard.kicad_pcb:
Copyright (C) 2023
